ProjetoBreathPE/Projeto-Breath-UFPE/Normas/README.md

A ABNT librerou acesso gratuito para as normas relativas aos ventiladores pulmonares. Para baixá-las, basta criar uma conta e fazer o download:

ABNT NBR IEC 60601-1:2010  	
Equipamento eletromédico
Parte 1: Requisitos gerais para segurança básica e desempenho essencial
https://www.abntcatalogo.com.br/norma.aspx?ID=80437

ABNT NBR ISO 80601-2-12:2014
Equipamento eletromédico - Parte 2-12: Requisitos particulares para a segurança básica e o desempenho essencial de ventiladores para cuidados críticos
https://www.abntcatalogo.com.br/norma.aspx?ID=326196#

ABNT NBR IEC 60601-1-8:2014 Versão Corrigida:2015  	
Equipamento eletromédico
Parte 1-8: Requisitos gerais para segurança básica e desempenho essencial - Norma colateral: Requisitos gerais, ensaios e diretrizes para sistemas de alarme em equipamentos eletromédicos e sistemas eletromédicos
https://www.abntcatalogo.com.br/norma.aspx?ID=348135

ABNT NBR ISO 10651-3:2014  	
Ventiladores pulmonares para uso médico
Parte 3: Requisitos particulares para ventiladores de transporte e emergência
https://www.abntcatalogo.com.br/norma.aspx?ID=324135

ABNT NBR ISO 10651-4:2011  	
Ventiladores pulmonares
Parte 4: Requisitos particulares para reanimadores operados manualmente
https://www.abntcatalogo.com.br/norma.aspx?ID=86381

ABNT NBR ISO 14971:2009  	
Produtos para a saúde — Aplicação de gerenciamento de risco a produtos para a saúde
https://www.abntcatalogo.com.br/norma.aspx?ID=55540
