ProjetoBreathPE/Projeto-Breath-UFPE/Projeto Eletroeletrônico/Planejamento/Fluxograna Alarmes.docx

Salva de Média Prioridade

Sim

]

Sim

]

Pausa

Pausa

Sim

]

Pausa

Limites atingidos?

Limites Atingidos?

Limites Atingidos?

Não

Não

Sim

]

Sim

]

Botão de Pausa?

Botão de Pausa?

Salva de Alta Prioridade

Registro

Registro

Sim

]

Limites Atingidos?

Não

Botão de Pausa?

Salva de Baixa Prioridade

Registro

Não
