ProjetoBreathPE/Projeto-Breath-UFPE/Projeto Eletroeletrônico/Circuito e PCB/Breath V2.0/v2.0.png

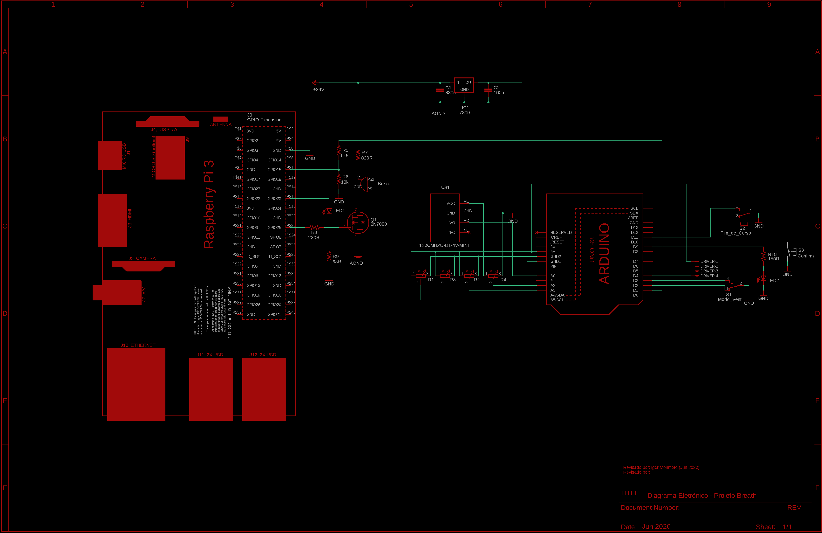
Projeto Eletroeletrônico/Circuito e PCB/Breath V2.0/v2.0.png
