ProjetoBreathPE/Projeto-Breath-UFPE/Projeto Mecânico/Lista_de_Material.xlsx

Lista de materiais estrutura mecânica |  | FORNECEDORES
 |  | HIPERMETAL |  | NORTEL |  | PORTELA |  | ESPERANÇA NORDESTE |  | DPN PARAFUSOS |  | MEDICAL |  | FERTEK
Quantidade | Descrição | PREÇO (R$) | TOTAL | PREÇO (R$) | TOTAL | PREÇO (R$) | TOTAL | PREÇO (R$) | TOTAL | PREÇO (R$) | TOTAL | PREÇO (R$) | TOTAL | PREÇO (R$) | TOTAL
16 | Parafuso Allen cabeça cilíndrica M3X16 | 0.40 | 6.40 | - |  | 1.85 | 29.60 | 0.04 | 0.64 | 0.60 | 9.60 | - |  | -
16 | Arruela Lisa M3 | - |  | - |  | 0.08 | 1.28 | 0.03 | 0.48 | 0.03 | 0.48 | - |  | -
16 | Porca M3 | - |  | - |  | 0.09 | 1.44 | 0.03 | 0.48 | 0.03 | 0.48 | - |  | -
4 | Parafuso Allen cabeça cilíndrica M5X20 | - |  | 0.20 | 0.80 | 0.35 | 1.40 | 0.09 | 0.36 | 0.40 | 1.60 | - |  | -
4 | Porca M5 | 0.25 | 1.00 | - |  | 0.10 | 0.40 | 0.06 | 0.24 | 0.04 | 0.16 | - |  | -
4 | Arruela Lisa M5 | - |  | - |  | 0.05 | 0.20 | 0.05 | 0.20 | 0.04 | 0.16 | - |  | -
2 | Parafuso Allen cabeça cilíndrica M6X16 | - |  | 0.67 | 1.34 | 0.15 | 0.30 | 0.13 | 0.26 | 0.50 | 1.00 | - |  | -
2 | Arruela Lisa M6 | - |  | - |  | 0.10 | 0.20 | 0.06 | 0.12 | 0.04 | 0.08 | - |  | -
2 | Porca M6 | 0.35 | 0.70 | 0.07 | 0.14 | 0.09 | 0.18 | 0.07 | 0.14 | 0.05 | 0.10 | - |  | -
2 | Parafuso Allen cabeça cilíndrica M4X16 | - |  | - |  | 0.10 | 0.20 | 0.06 | 0.12 | 0.40 | 0.80 | - |  | -
2 | Porca M4 | - |  | 0.04 | 0.08 | 0.55 | 1.10 | 0.04 | 0.08 | 0.04 | 0.08 | - |  | -
2 | Arruela M4 | - |  | - |  | 0.05 | 0.10 | 0.04 | 0.08 | 0.04 | 0.08 | - |  | -
1 | Castanha TR10 | - |  | - |  | - |  | - |  | - |  | - |  | -
1 | Fuso TR10 | - |  | - |  | - |  | - |  | - |  | - |  | -
1 | Ambu (adulto) | - |  | - |  | - |  | - |  | - |  | 228.70 | 228.70 | -
1 | Rolamento 627-2Z | - |  | 35.00 | 35.00 | 7.00 | 7.00 | - |  | - |  | - |  | -
1 | Acoplamento fexível para motor de passo 6,35 X 6,35 | - |  | - |  | - |  | - |  | - |  | - |  | -
1 | Motor de Passo Nema 23, 15kgf/cm | - |  | - |  | - |  | - |  | - |  | - |  | -
1 | Tarugo de Alumínio 2 1/2" (100mm) | 33.00 | 33.00 | - |  | - |  | - |  | - |  | - |  | -
1 | Chapa de acrílico espessura de 5mm e área 0,5 m² | - |  | - |  | - |  | - |  | - |  | - |  | -
1 | Anel elástico para furo Ø22 | - |  | - |  | - |  | - |  | - |  | - |  | -
1 | Acrílico 5 mm (1000 X 2050) | 793.00 | 793.00 | - |  | - |  | - |  | - |  | - |  | -
SOMATÓRIO |  | Soma | 834.10 | Soma | 37.36 | Soma | 43.40 | Soma | 3.20 | Soma | 14.62 | Soma | 228.70 | Soma | 0.00
Acrílico
Quantidade | Comprimento | Largura | Espessura | Área (mm²)
2 | 371 | 182 | 5 | 135044
2 | 112 | 45 | 5 | 10080
1 | 182 | 50 | 5 | 9100
1 | 98 | 102 | 5 | 9996
2 | 105 | 35 | 5 | 7350
1 | 98 | 54 | 5 | 5292
1 | 119 | 112 | 5 | 13328
2 | 160 | 105 | 5 | 33600
Total |  |  |  | 223790
