ProjetoBreathPE/Projeto-Breath-UFPE/Projeto Mecânico/Ambus_utilizados_em_PE.xlsx

Modelos de ambu utilizados em hospitais de PE
Hospital | Marca do ambu | Descrição | Fornecedor | Valor (R$)
Santa Joana | Protec | AMBU SILICONE ADULTO | Medical | 229.7
Santa Joana | Protec | AMBU SILICONE ADULTO | Medsystem | 194.84
