ProjetoBreathPE/Projeto-Breath-UFPE/Projeto Mecânico/Desenhos em PDF do modelo/Cópia de Componente32 = placa fix inf 1.pdf

41

21

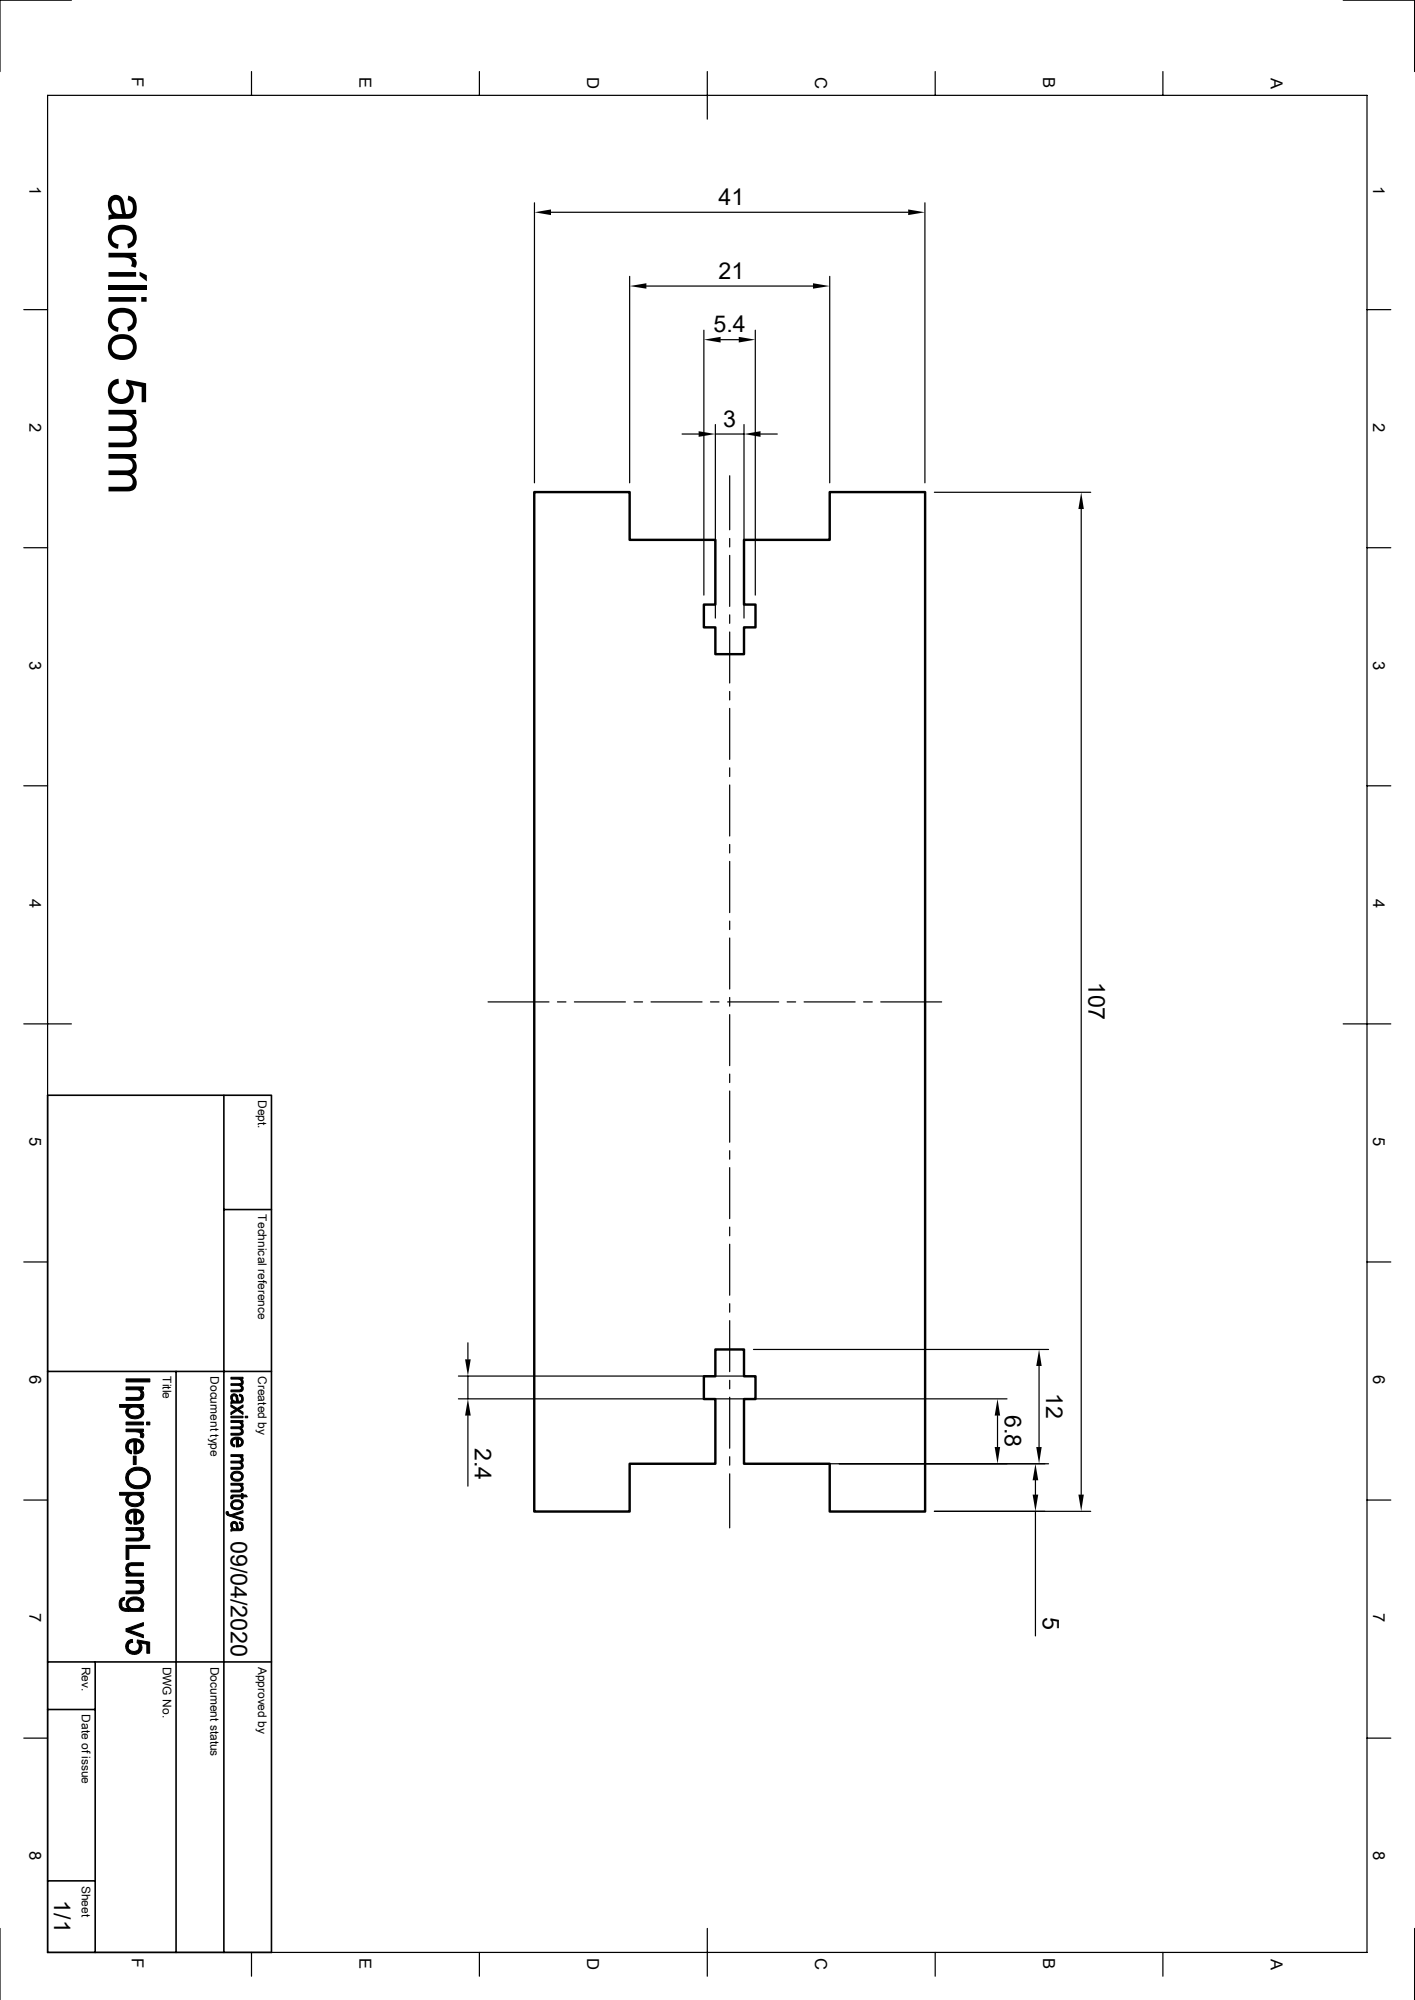
[picture p11: page 1]
6.8 acrílico 5mm

1 A 2 3 4 5 6 7 8 1 2 3 4 5 6 7 8 FEDCB FEDCBA Dept. Technical reference Created by Approved by Title DWG No. Document type Document status Rev. Date of issue Sheet 09/04/2020 1/1 107
