ProjetoBreathPE/Projeto-Breath-UFPE/Projeto Mecânico/Desenhos em PDF do modelo/Base esquerda rev.1.pdf

25

366

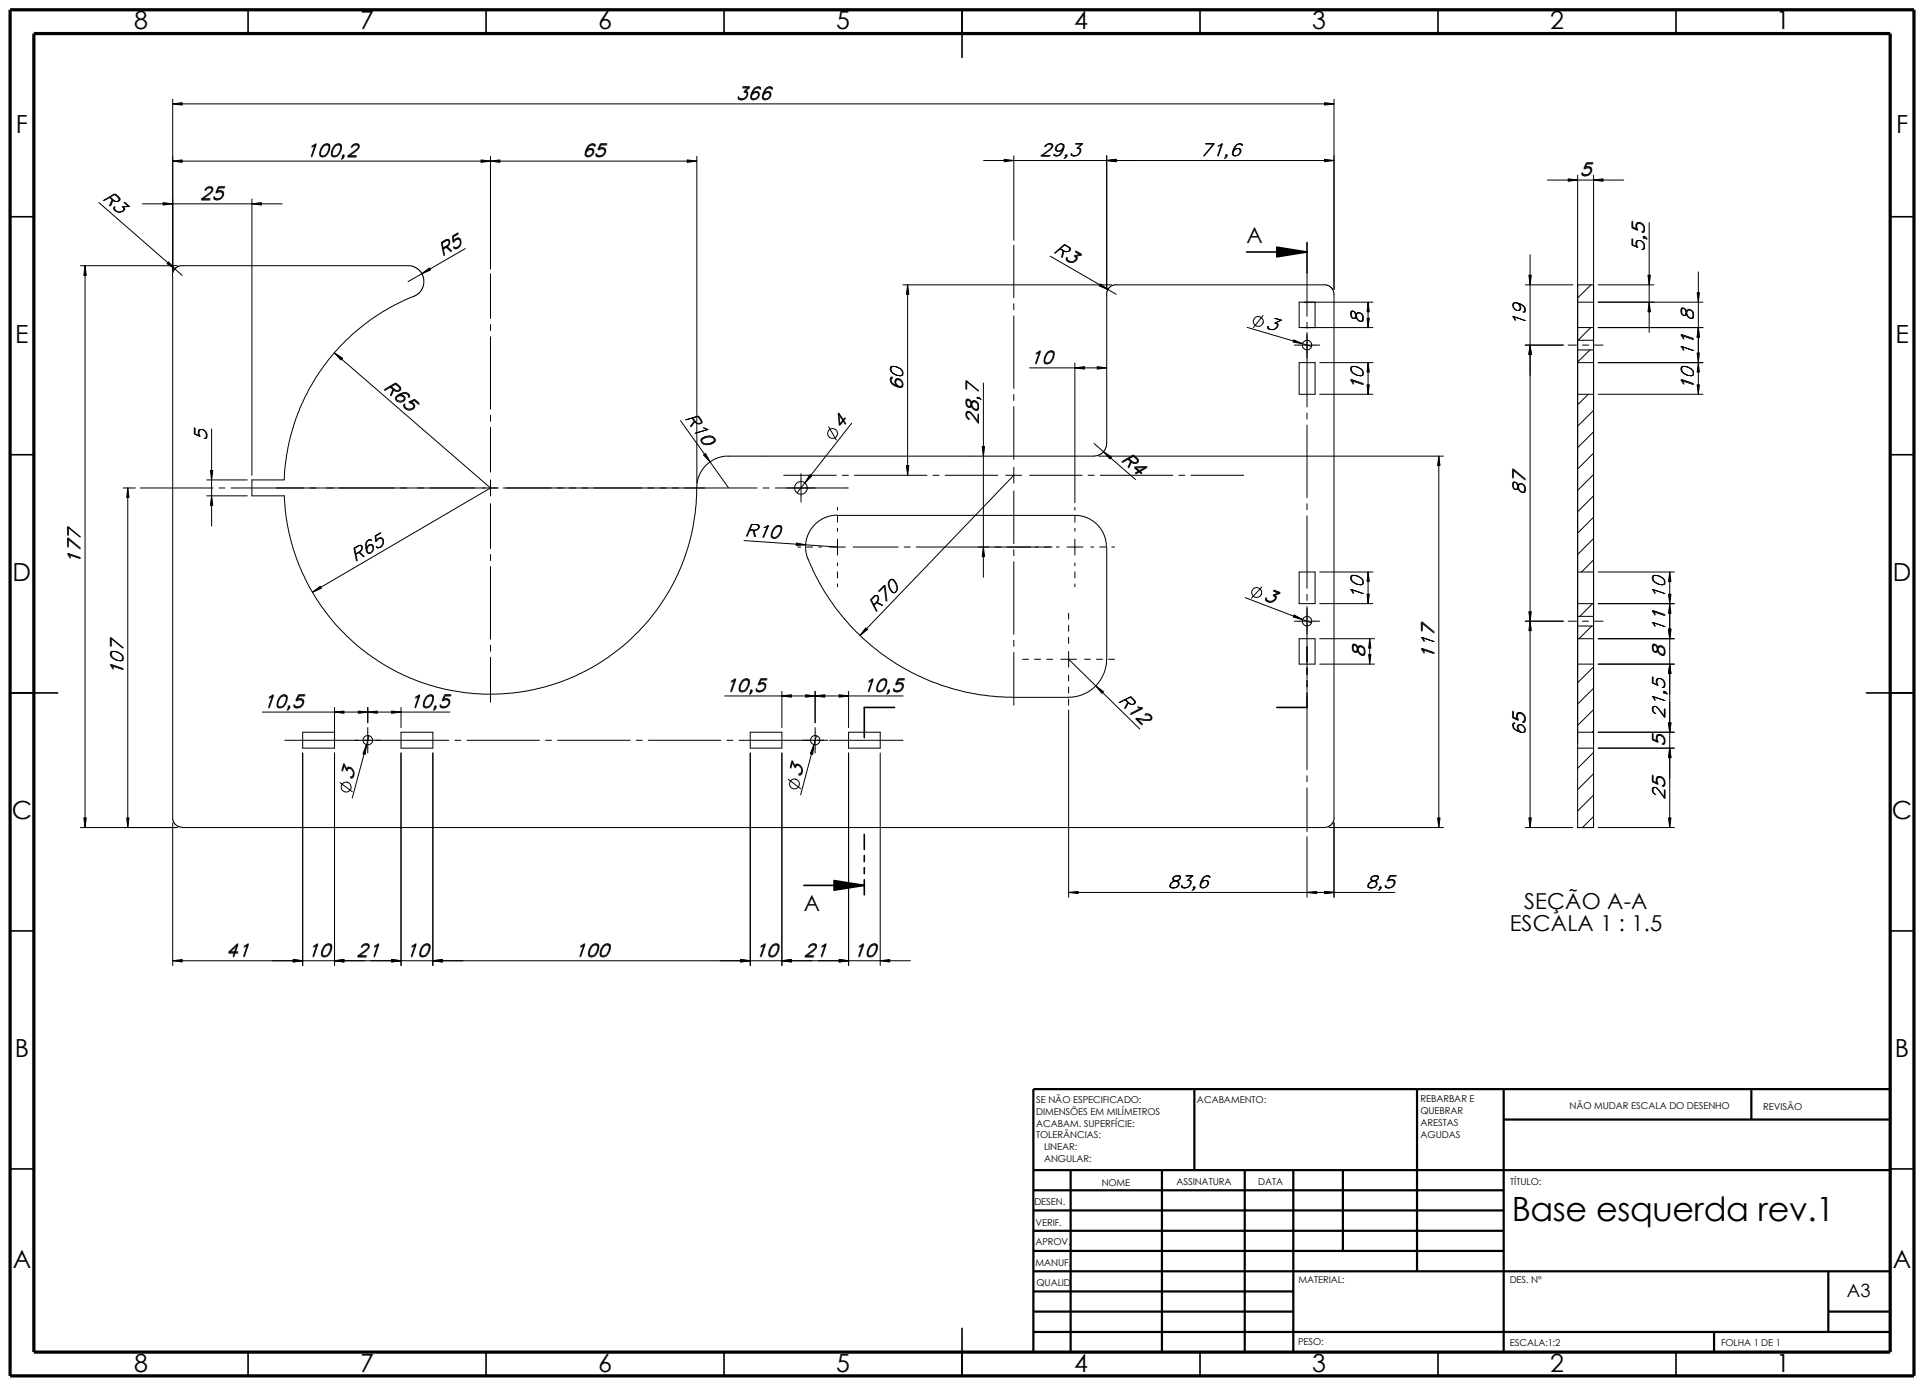
[picture p12: page 1]

NOME | ASSINATURA | DATA | | | | TÍTULO: Base esquerda rev.1

DESEN.

VERIF.

APROV.

MANUF.

QUALID | | | | MATERIAL: | DES. Nº | A3
