ProjetoBreathPE/Projeto-Breath-UFPE/Projeto Mecânico/Desenhos em PDF do modelo/Cópia de Componente35 = placa apoio ambu 1.pdf

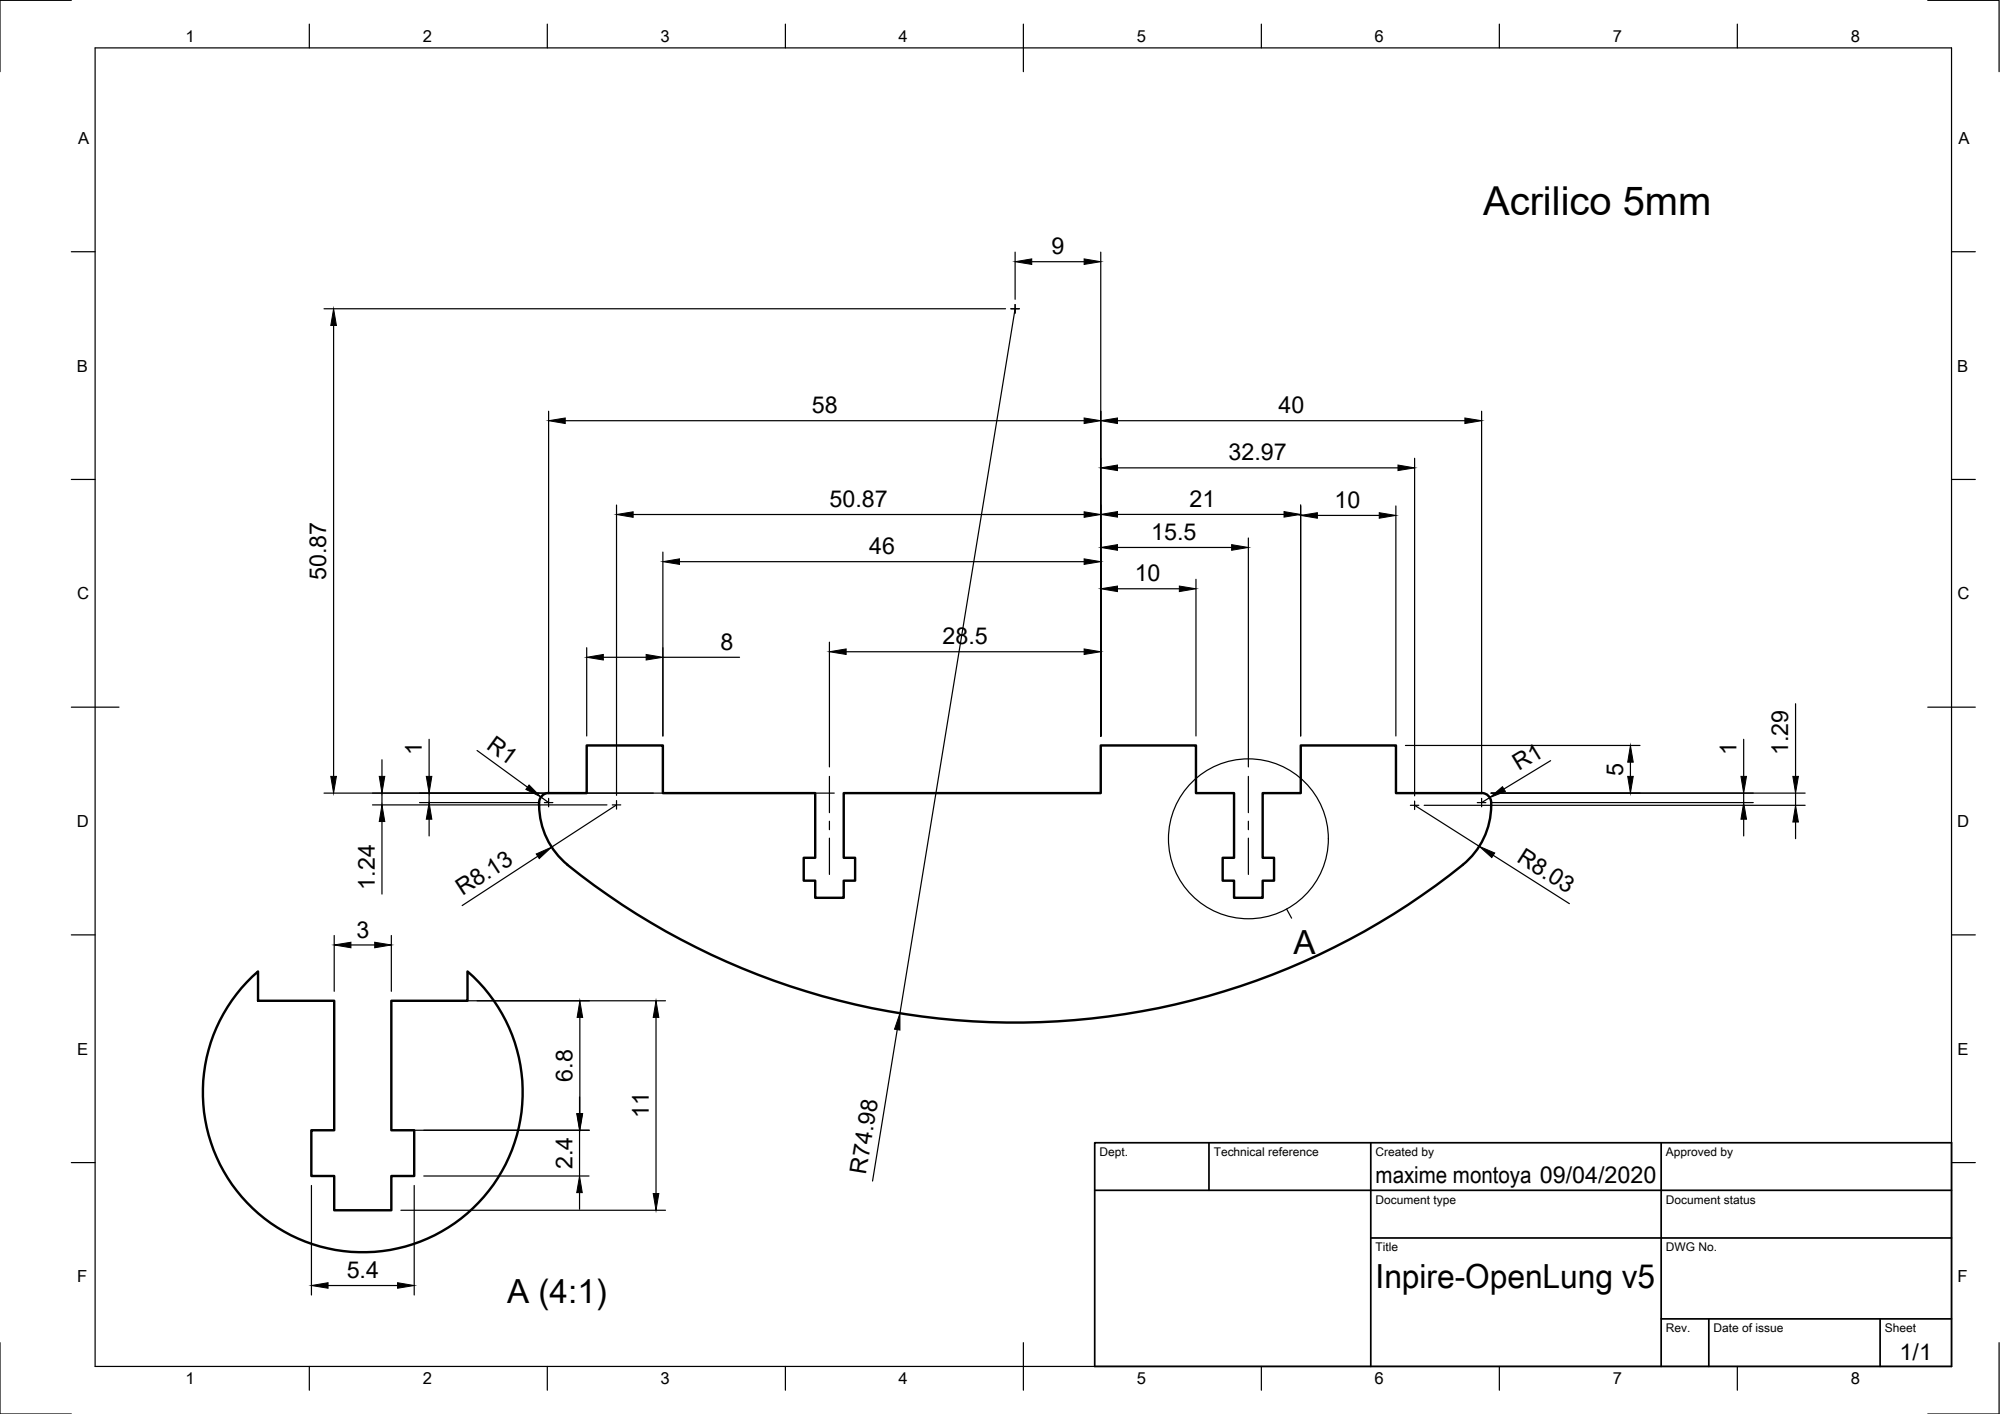
[picture p13: page 1]
maxime montoya R74.98; Acrilico 5mm

Dept. | Technical reference | Created by 09/04/2020 | Approved by

Document type | Document status

Title Inpire-OpenLung v5 | DWG No.

Rev. | Date of issue | Sheet 1/1
