ProjetoBreathPE/Projeto-Breath-UFPE/Projeto Mecânico/Desenhos em PDF do modelo/Fuso trapezoidal TR10.pdf

E

F

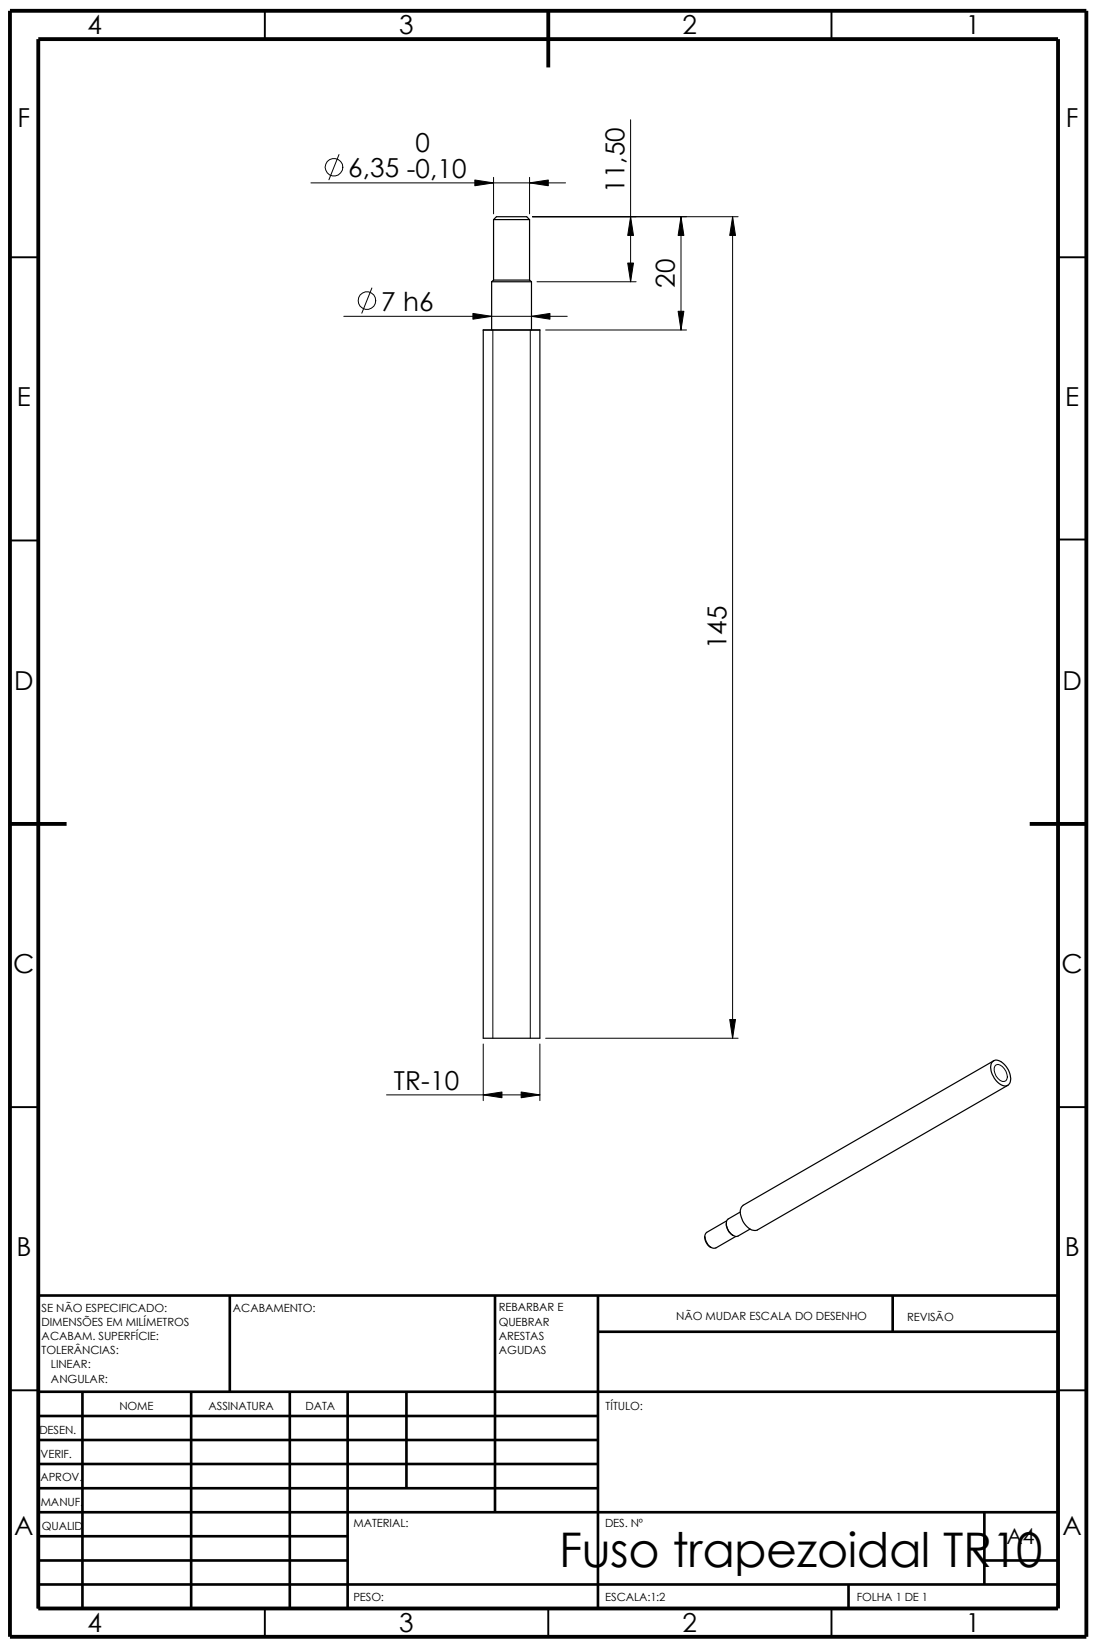
[picture p14: page 1]
NÃO MUDAR ESCALA DO DESENHO; REVISÃO; ESCALA:1:2; FOLHA 1 DE 1; PESO:; AGUDAS; ACABAMENTO:; REBARBAR E QUEBRAR ARESTAS

SE NÃO ESPECIFICADO:
DIMENSÕES EM MILÍMETROS
ACABAM. SUPERFÍCIE:
TOLERÂNCIAS:
LINEAR:
ANGULAR:

NOME | ASSINATURA | DATA | | | | TÍTULO:

DESEN.

VERIF.

APROV.

MANUF.

QUALID | | | | MATERIAL: Fuso trapezoidal TR10 | DES. Nº | A4
