ProjetoBreathPE/Projeto-Breath-UFPE/Projeto Mecânico/Desenhos em PDF do modelo/Guia.pdf

E

F

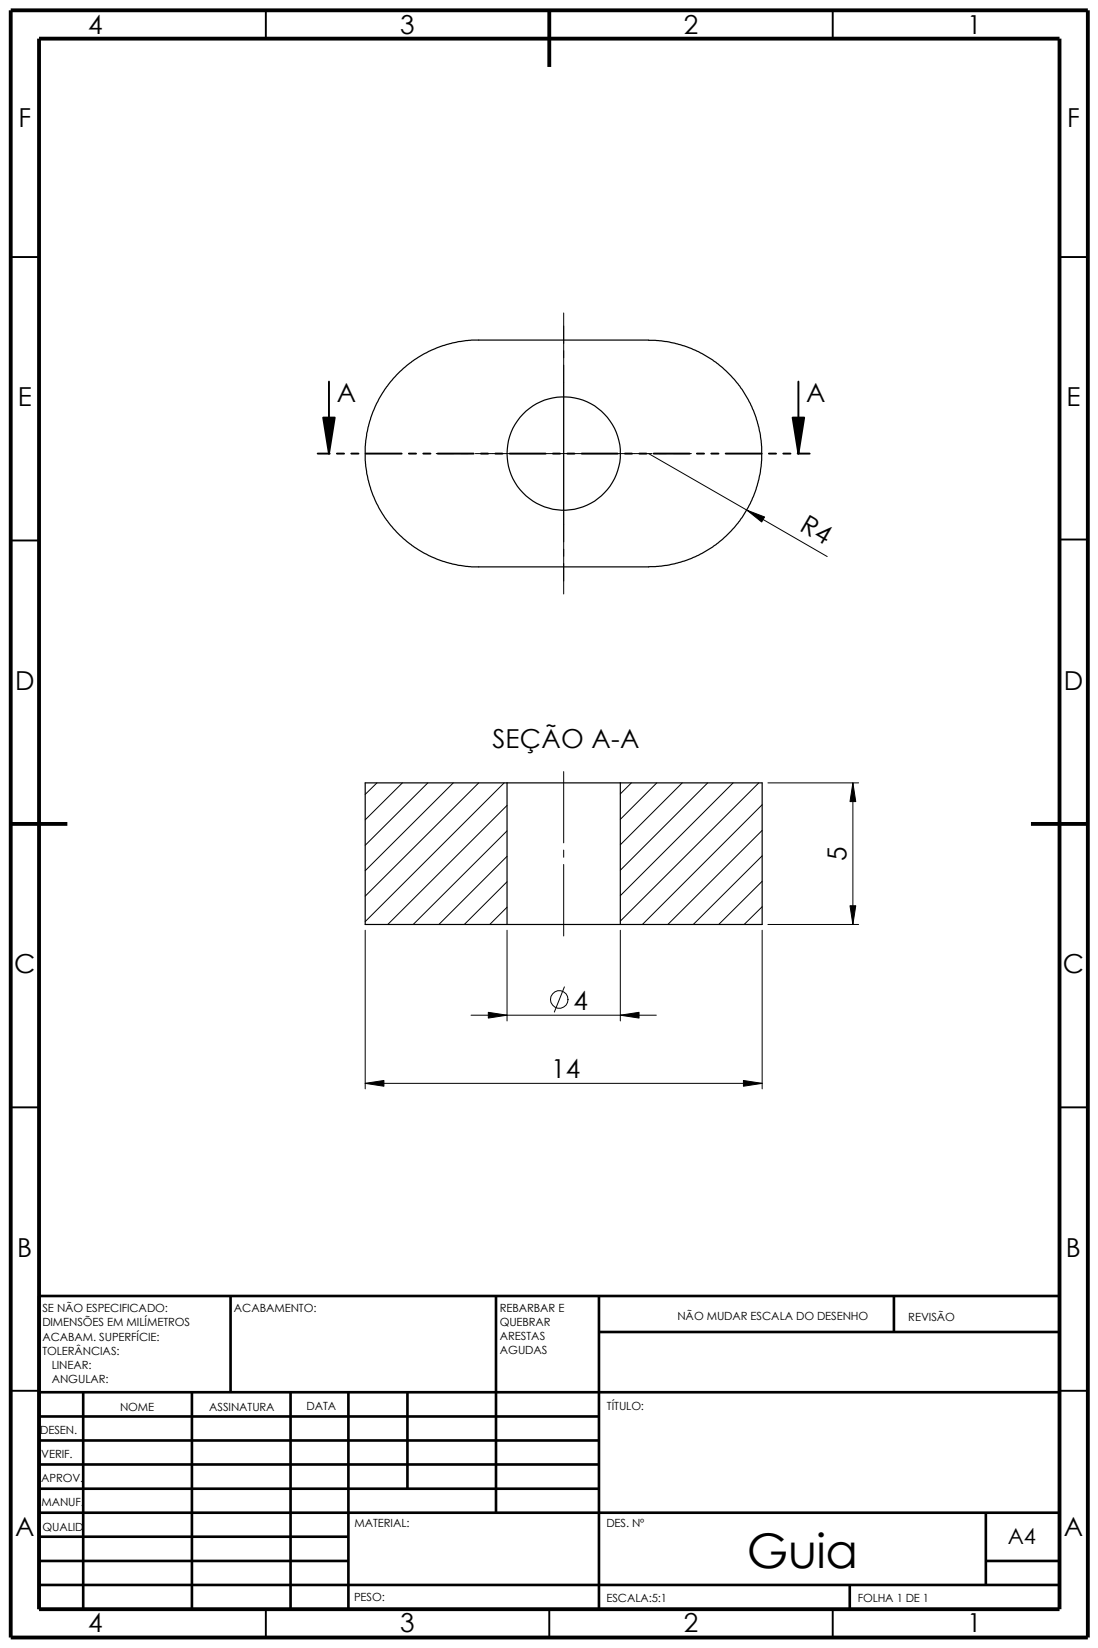
[picture p15: page 1]
NÃO MUDAR ESCALA DO DESENHO; REVISÃO; ESCALA:5:1; FOLHA 1 DE 1; PESO:; AGUDAS; ACABAMENTO:; REBARBAR E QUEBRAR ARESTAS; SEÇÃO A-A

SE NÃO ESPECIFICADO:
DIMENSÕES EM MILÍMETROS
ACABAM. SUPERFÍCIE:
TOLERÂNCIAS:
LINEAR:
ANGULAR:

NOME | ASSINATURA | DATA | | | | TÍTULO:

DESEN.

VERIF.

APROV.

MANUF.

QUALID | | | | MATERIAL: | DES. Nº Guia | A4
