ProjetoBreathPE/Projeto-Breath-UFPE/Projeto Mecânico/Desenhos em PDF do modelo/Plate pistão.PDF

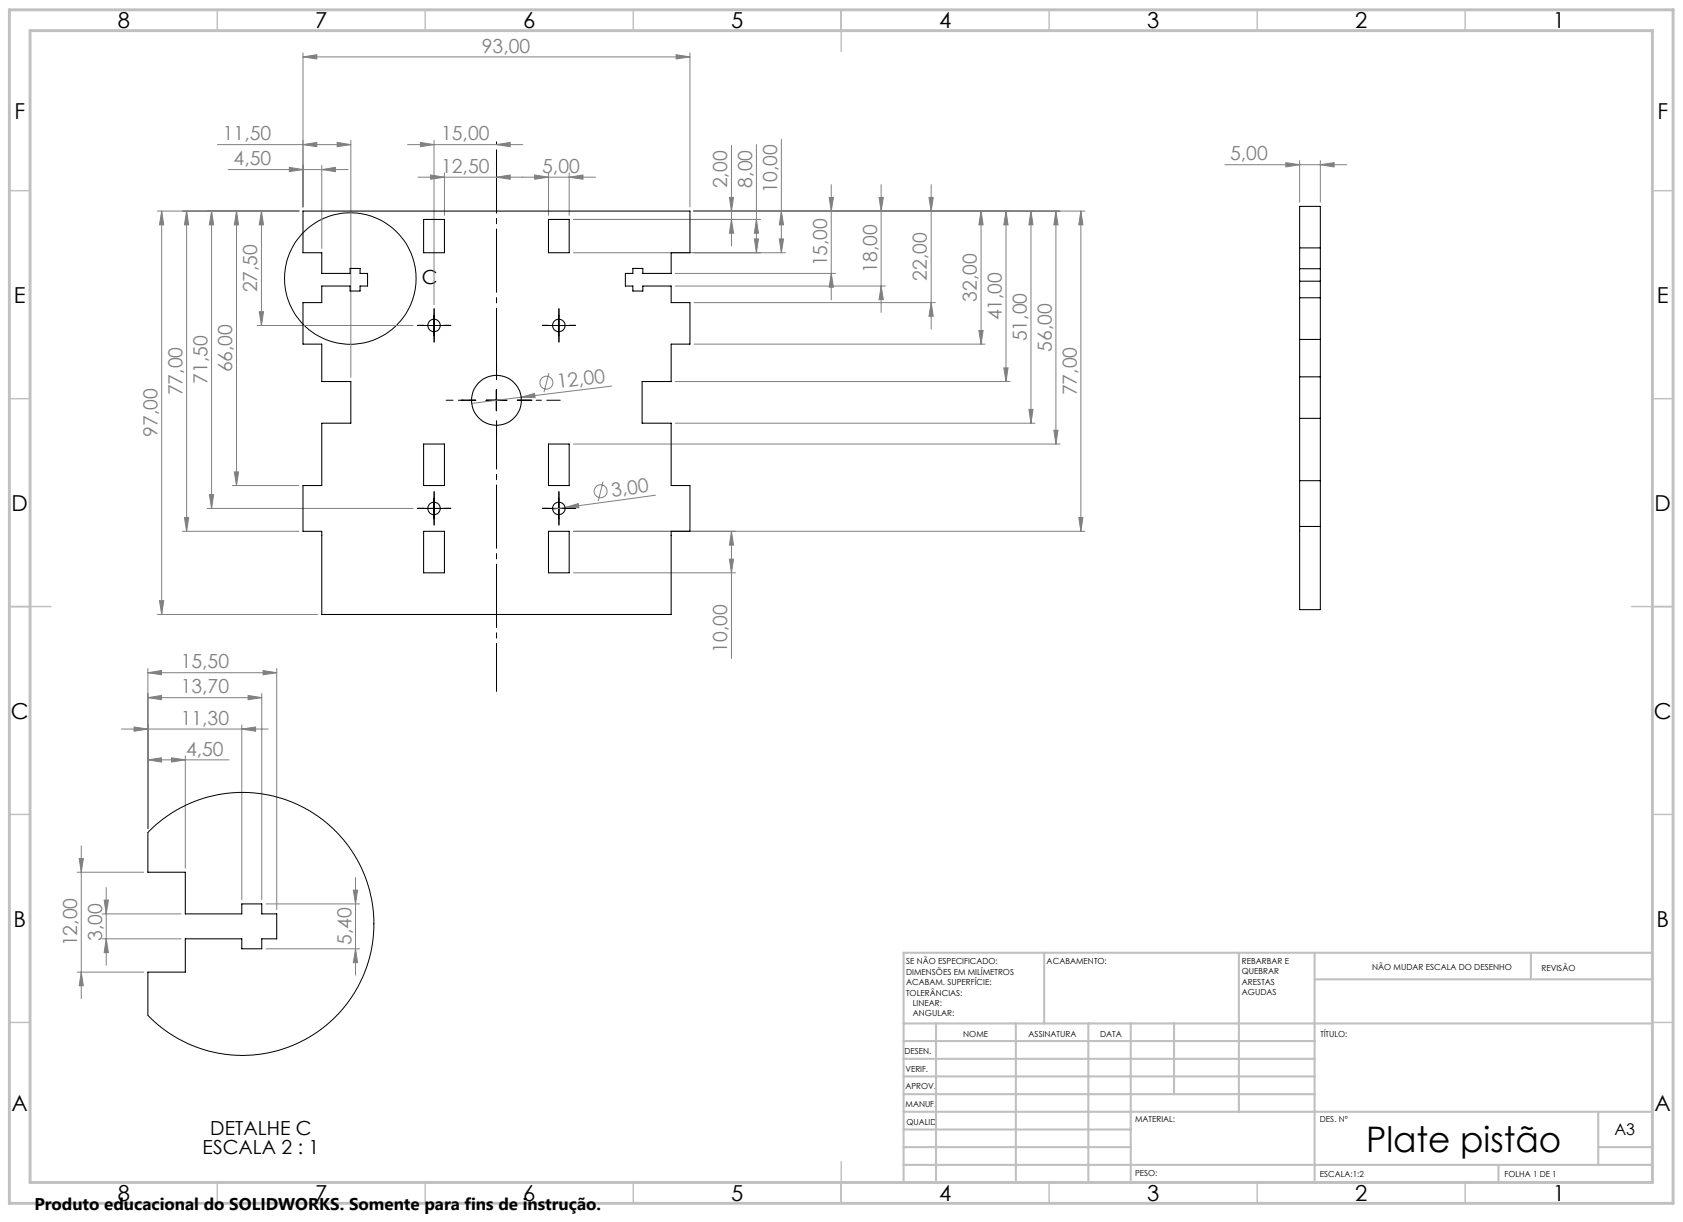
[picture p16: page 1]
ACABAMENTO:; REBARBAR E; NÃO MUDAR ESCALA DO DESENHO; REVISÃO; ESCALA:1:2; FOLHA 1 DE 1

SE NÃO ESPECIFICADO:
DIMENSÕES EM MILÍMETROS
ACABAM. SUPERFÍCIE:
TOLERÂNCIAS:
LINEAR:
ANGULAR:

NOME | ASSINATURA | DATA | | | | TÍTULO:

DESEN.
VERIF.
APROV.
MANUF.
QUALID | | | | MATERIAL: | DES. Nº Plate pistão | A3

DETALHE C
ESCALA 2 : 1
Produto educacional do SOLIDWORKS. Somente para fins de instrução.
