ProjetoBreathPE/Projeto-Breath-UFPE/Projeto Eletroeletrônico/Planejamento/Fluxograna Alarmes.pdf

### Registro

## Limites atingidos?

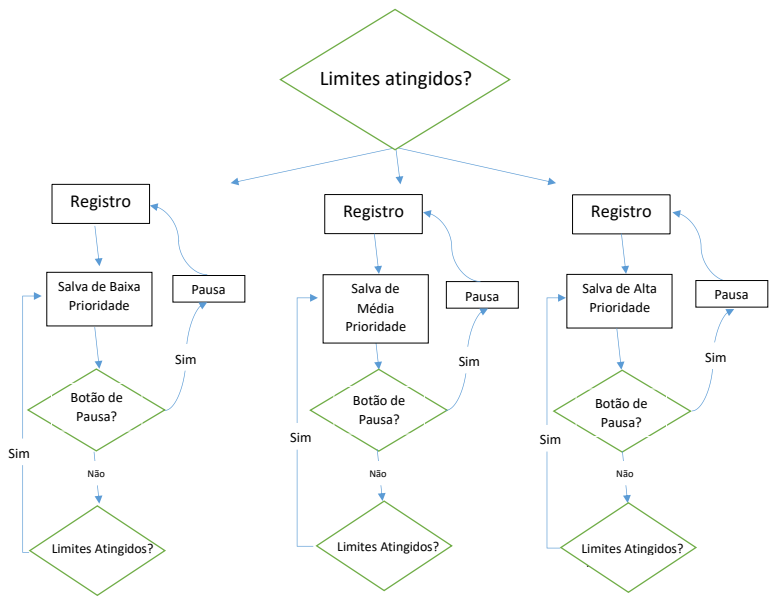
[picture p17: page 1]
Botão de Pausa?; Sim; Limites Atingidos?; Não; Pausa; Registro

Salva de Baixa
Prioridade

Pausa Salva de
Média

Salva de Alta
