ProjetoBreathPE/Projeto-Breath-UFPE/Projeto Mecânico/Desenhos em PDF do modelo/encosto ambu Drawing.pdf

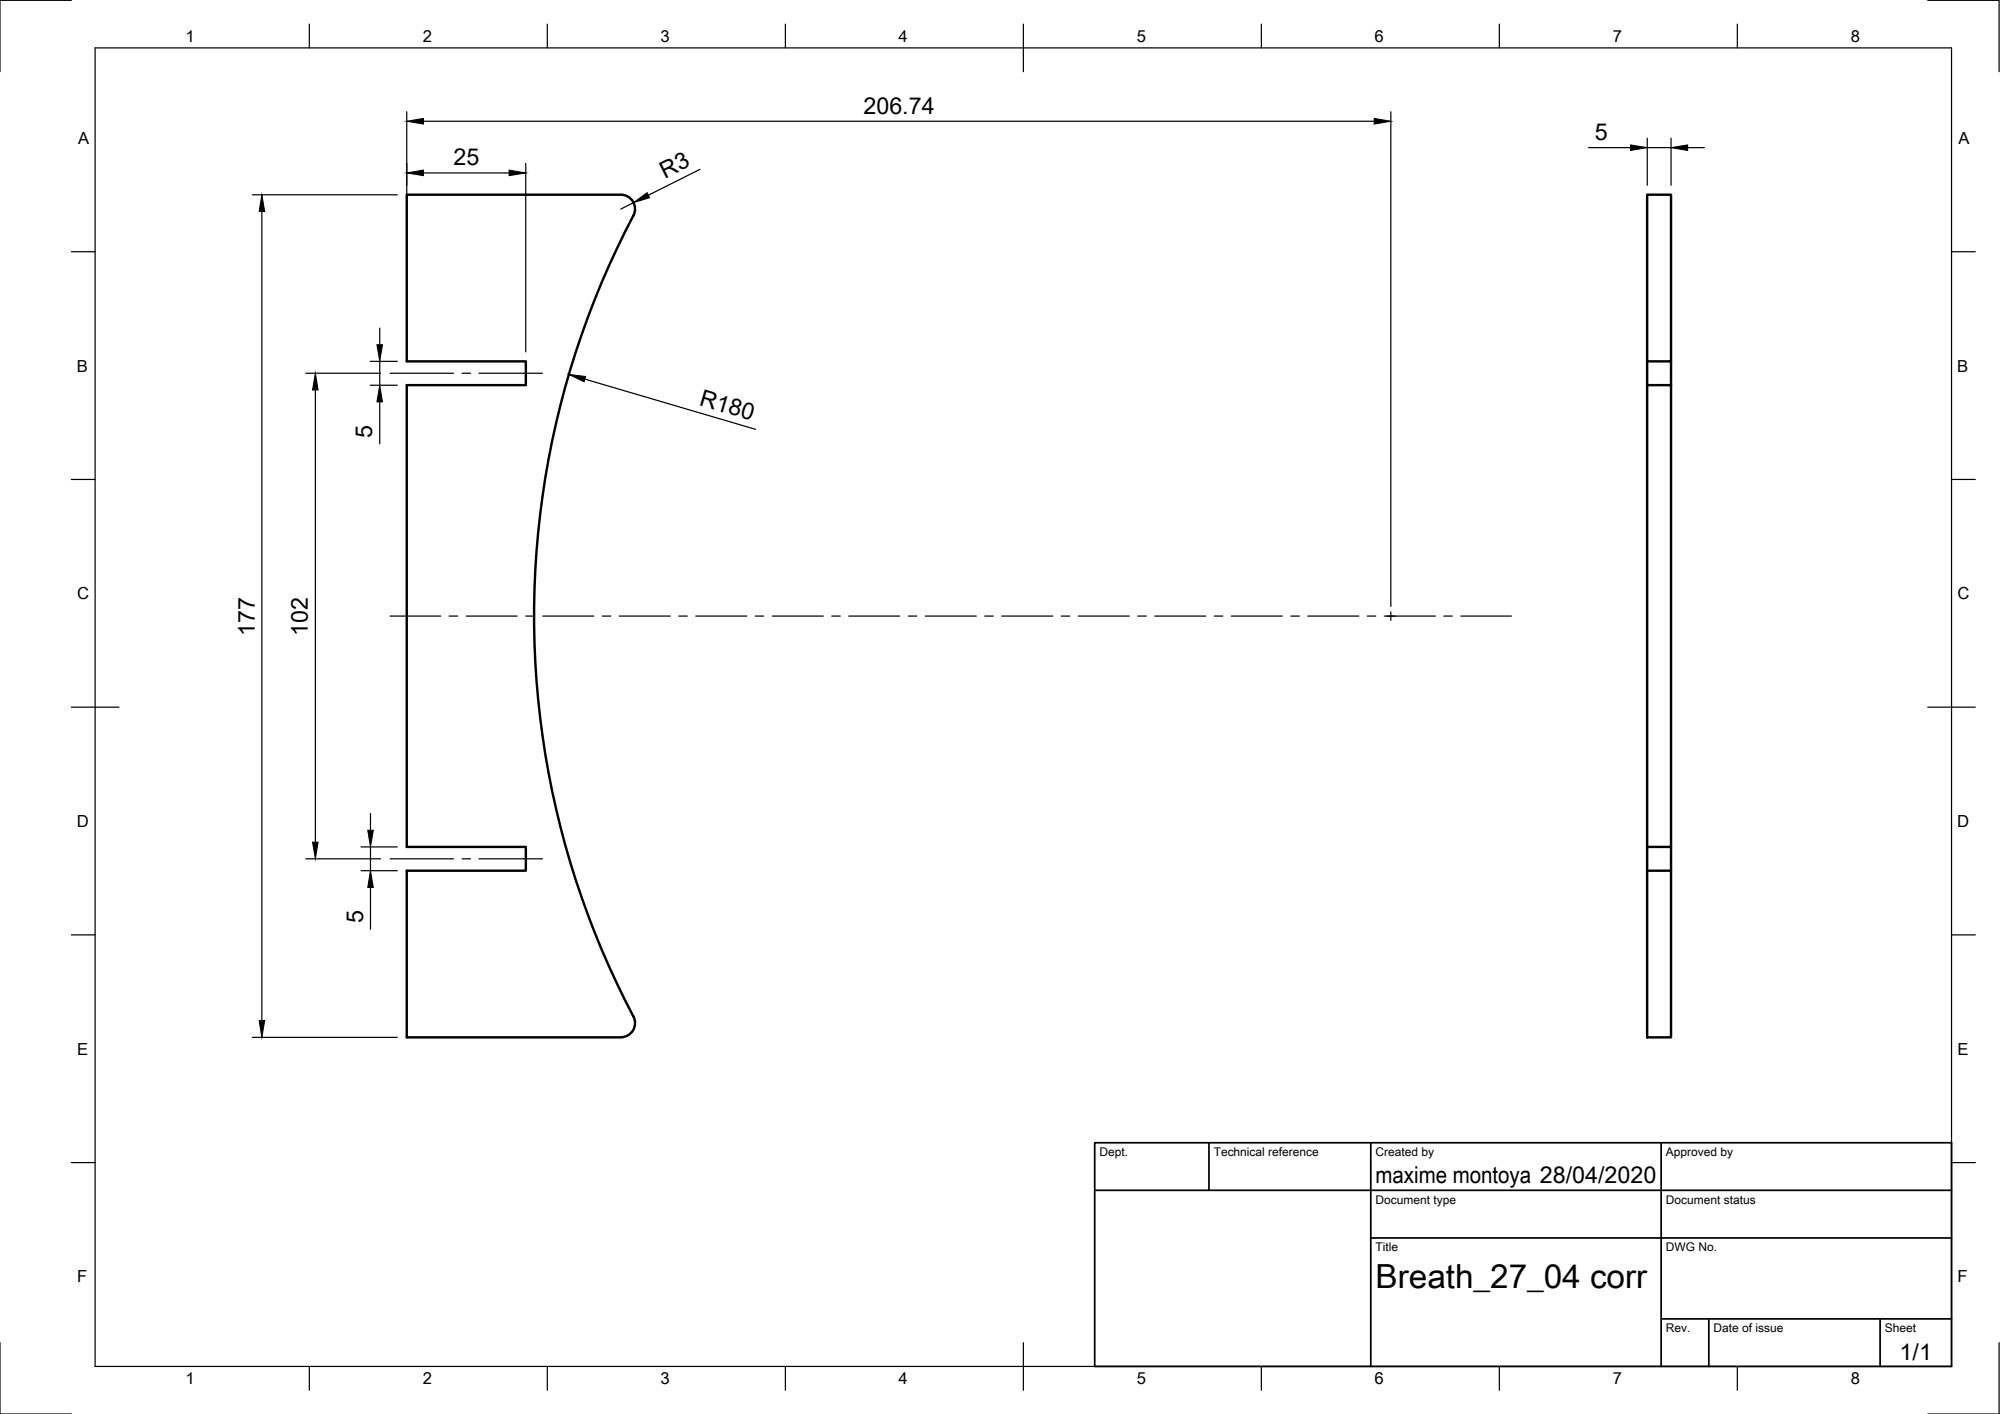
[picture p18: page 1]

Dept. | Technical reference | Created by maxime montoya 28/04/2020 | Approved by

Document type | Document status

Title Breath_27_04 corr | DWG No.

Rev. | Date of issue | Sheet 1/1
