ProjetoBreathPE/Projeto-Breath-UFPE/Projeto Mecânico/Desenhos em PDF do modelo/motor plate Drawing.pdf

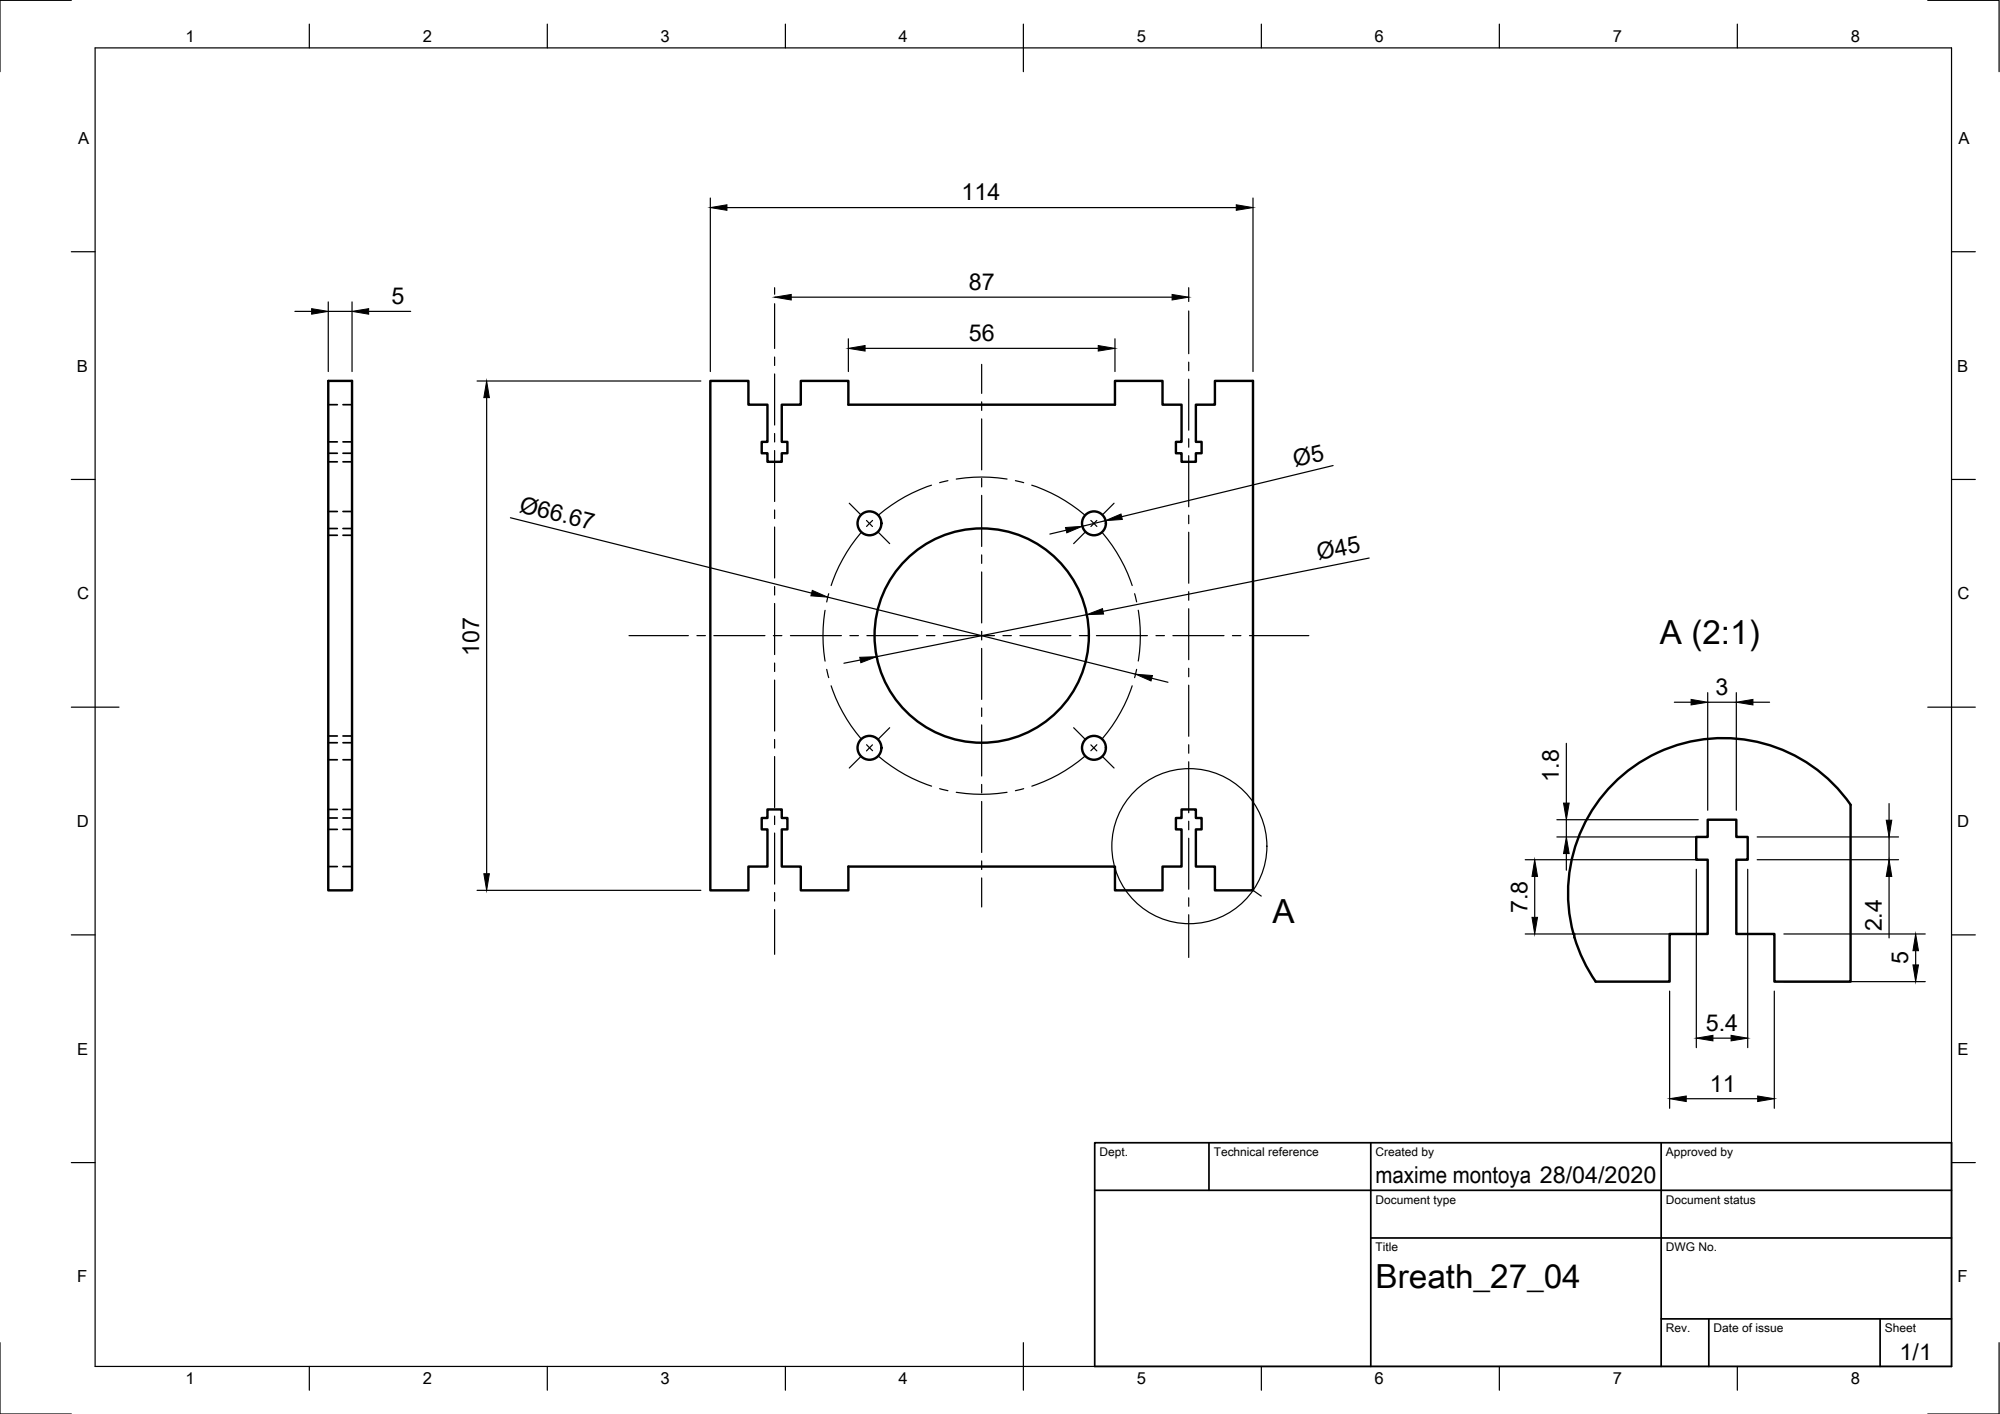
[picture p19: page 1]
maxime montoya 107

Dept. | Technical reference | Created by 28/04/2020 | Approved by

Document type | Document status

Title Breath_27_04 | DWG No.

Rev. | Date of issue | Sheet 1/1
