ProjetoBreathPE/Projeto-Breath-UFPE/Projeto Eletroeletrônico/Circuito e PCB/Breath V1.0/Esquema V1.0.pdf

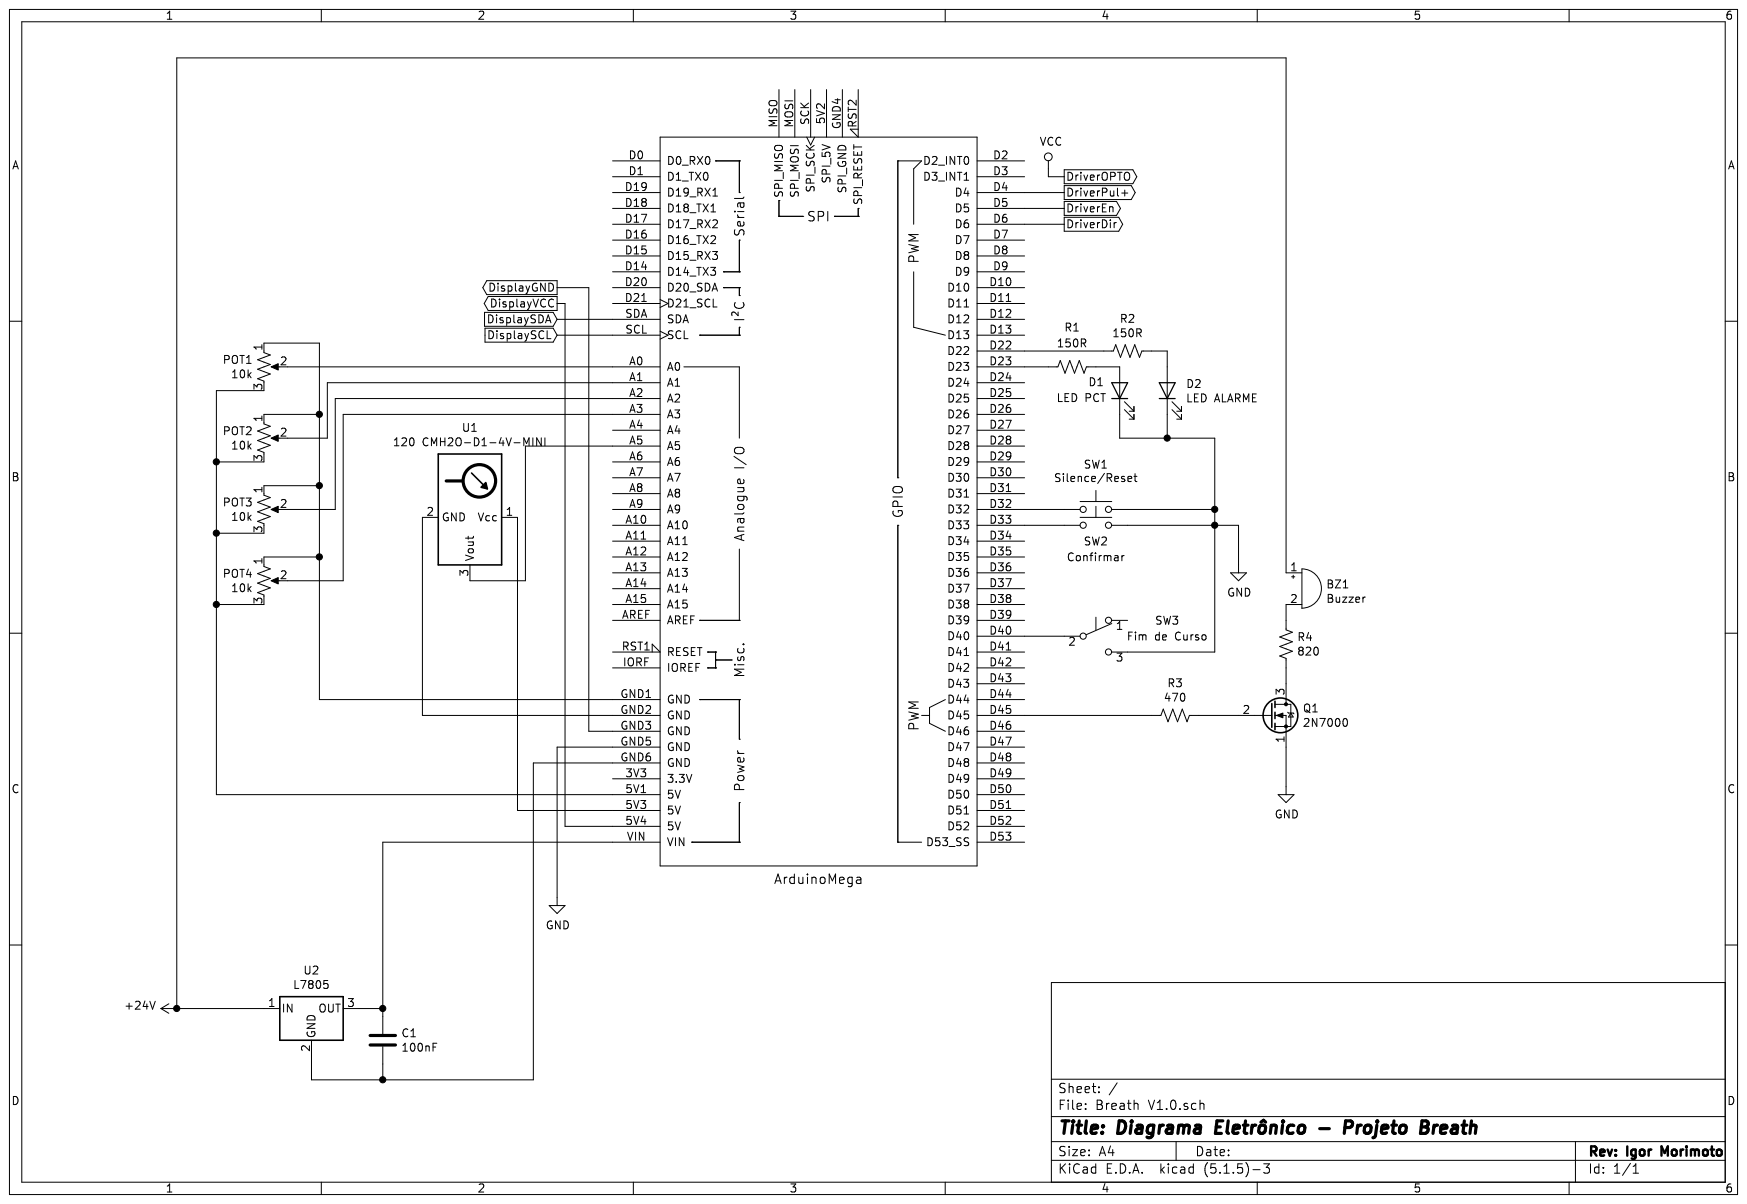
[picture p22: page 1]
