ProjetoBreathPE/Projeto-Breath-UFPE/(commit log)

2020-06-16 Adcionado esqueleto do código do arduino
2020-07-27 Update main.cpp
    Atualização tipo de chave Modo ventilatótio (on/off)
2020-08-03 Implementação da leitura do sensor de pressão
    Checar conformidade e precisão devido à não linearidade.
2020-08-16 Update main.cpp
    Biblioteca de constantes separada.
2020-08-16 Update Constantes.h
    Ajuste da resolução da pressão por causa da resolução do conversor A/D d arduíno em relação ao range do sensor
2020-09-16 Teste bem sucedido com apenas 1 ressalva
    Código testado em 16/09/2020 e funcionando apanas com um erro intermitente:
    Traceback (most recent call last):
    File "/media/pi/MORIMOTO/rapberry.txt", line 7, in <module>
    if ser.in_waiting > 0:
    File "/usr/lib/python3/dist-packages/serial/serialposix.py", line 467, in in_waiting
    s = fcntl.ioctl(self.fd, TIOCINQ, TIOCM_zero_str)
    OSError: [Errno 5] Input/output error
2020-09-22 Correções e implementação da comunicação
    Comunicação de acordo com código previamente testado.
2020-09-22 Correções e implementação da comunicação a partir de um código já testado.
    Testado no Arduino em 22/08/2020 OK
2020-09-30 Codigo controle step motor Daniel
    Para adaptação e teste
2020-10-06 Teste de controle do motor
2020-10-06 Adaptação para teste do controle
2020-10-29 Upload de arquivos
    [Breath V1.0.kicad_pcb, Breath V1.0.sch, Diagrama Eletrônico V2.0.sch]
